KidsLabDe/tagged/freecad/preview_back.png

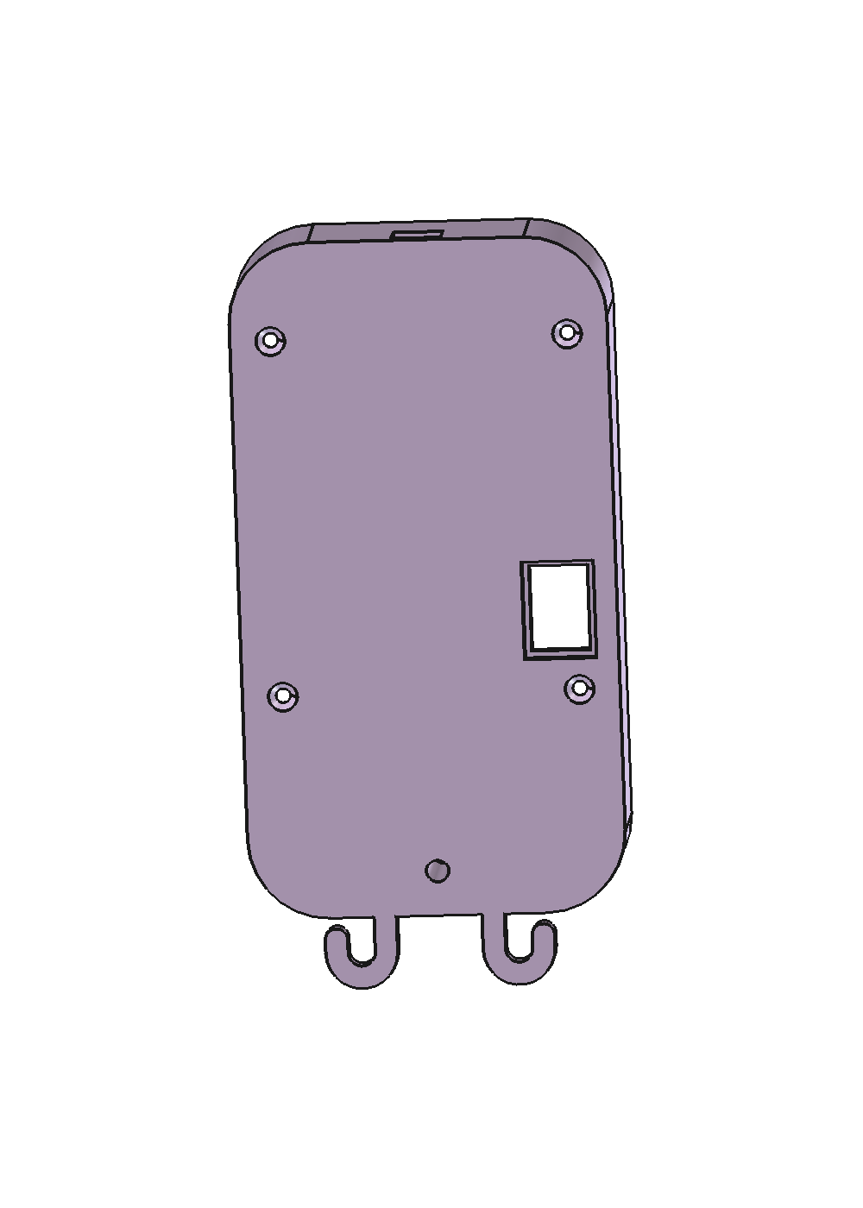
freecad/preview_back.png
