KidsLabDe/tagged/freecad/preview_front.png

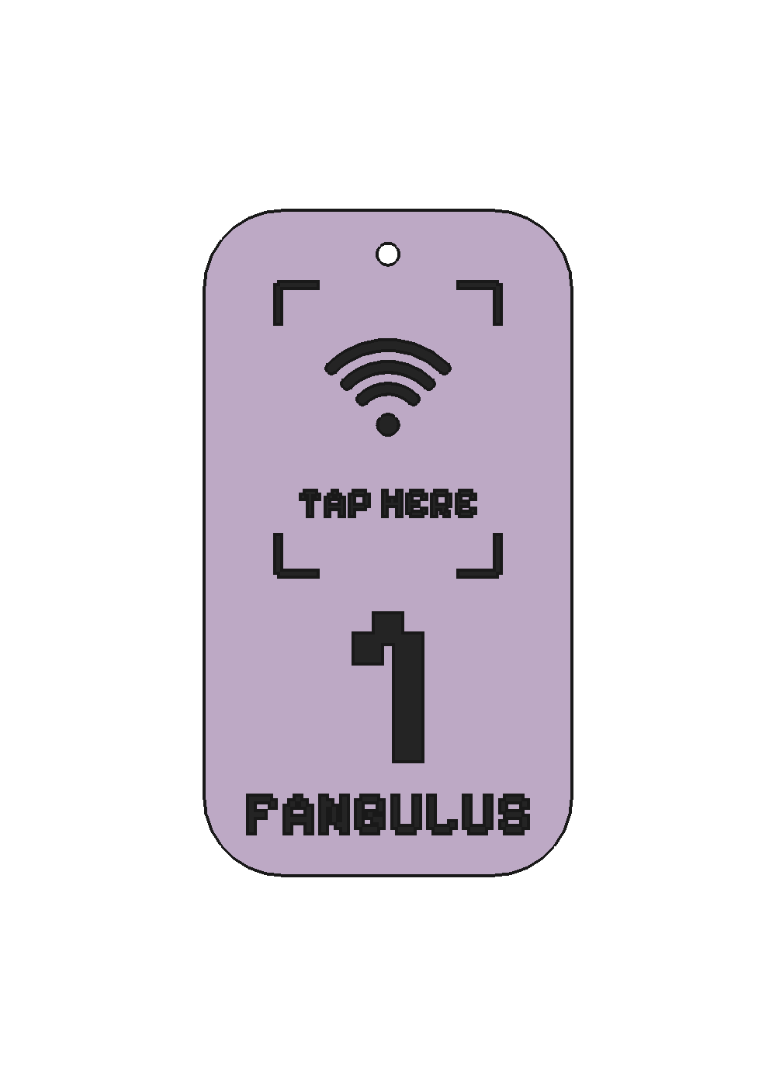
freecad/preview_front.png
