KidsLabDe/tagged/freecad/preview_fronten.png

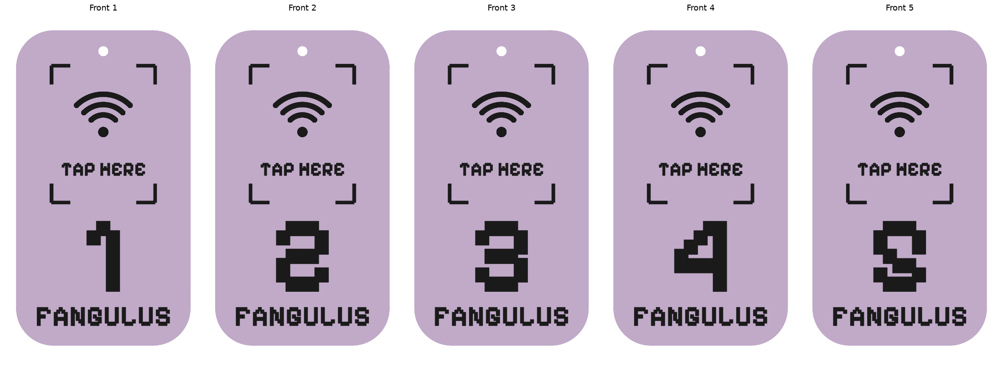
freecad/preview_fronten.png
