KidsLabDe/tagged/freecad/preview_inside.png

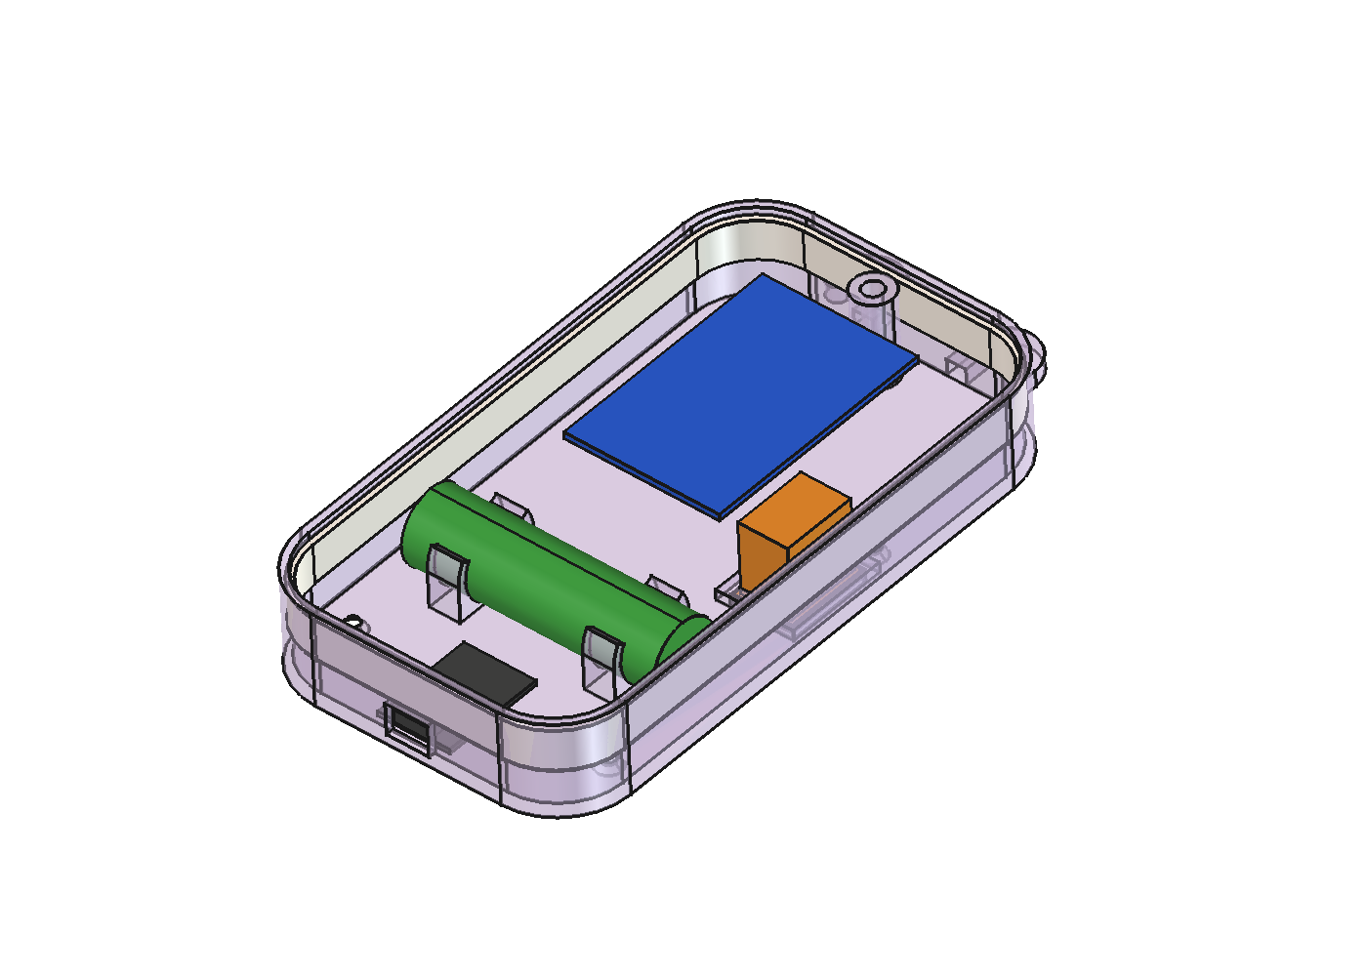
freecad/preview_inside.png
