KidsLabDe/tagged/freecad/DiscCase_Prusa_Front_1_2.3mf

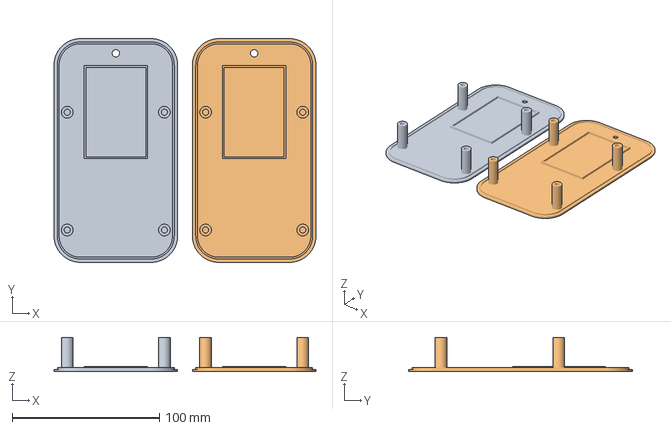
[picture p5: CAD file, 2026-10-29]
freecad/DiscCase_Prusa_Front_1_2.3mf
178.0 x 152.0 x 23.4 mm
Fangulus Front 1
Fangulus Front 2
