KidsLabDe/tagged/freecad/sample/flexbatter18650Px1.stl

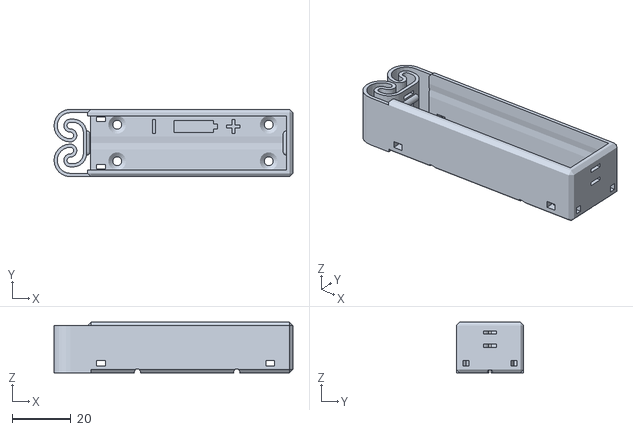
[picture p6: CAD file, 2026-10-28]
freecad/sample/flexbatter18650Px1.stl
81.2 x 22.9 x 17.2
