KidsLabDe/tagged/freecad/DiscCase_Prusa_Front_3_4.3mf

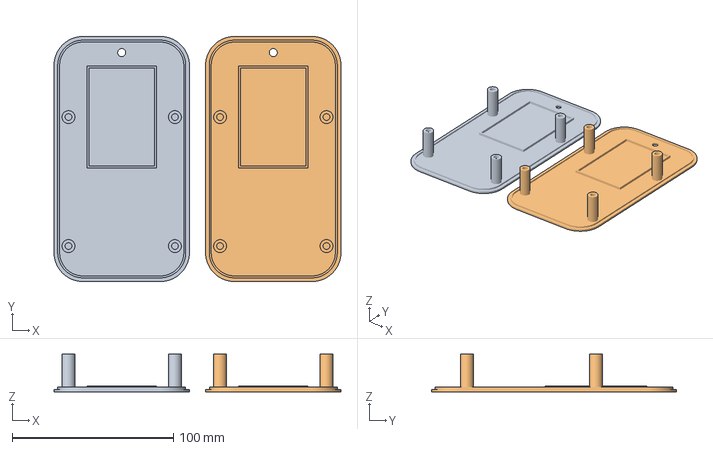
[picture p7: CAD file, 2026-10-29]
freecad/DiscCase_Prusa_Front_3_4.3mf
178.0 x 152.0 x 23.4 mm
Fangulus Front 3
Fangulus Front 4
