KidsLabDe/tagged/freecad/DiscCase_Prusa_Front_5.3mf

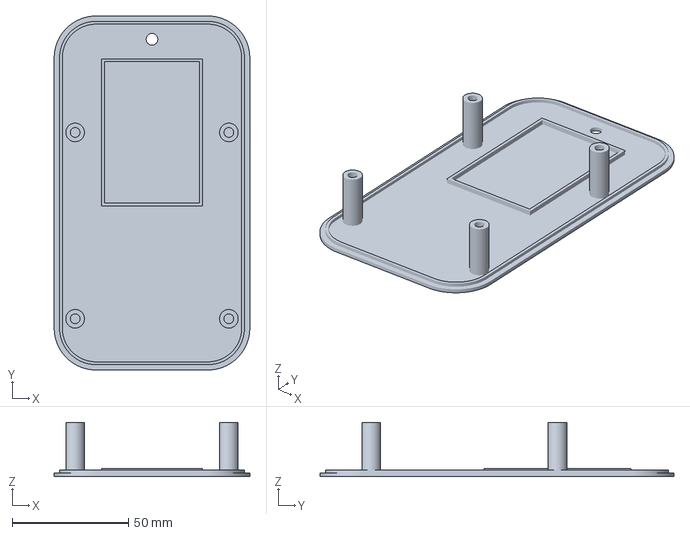
[picture p8: CAD file, 2026-10-29]
freecad/DiscCase_Prusa_Front_5.3mf
84.0 x 152.0 x 23.4 mm
