KidsLabDe/tagged/freecad/DiscCase_Front_1_Bambu.3mf

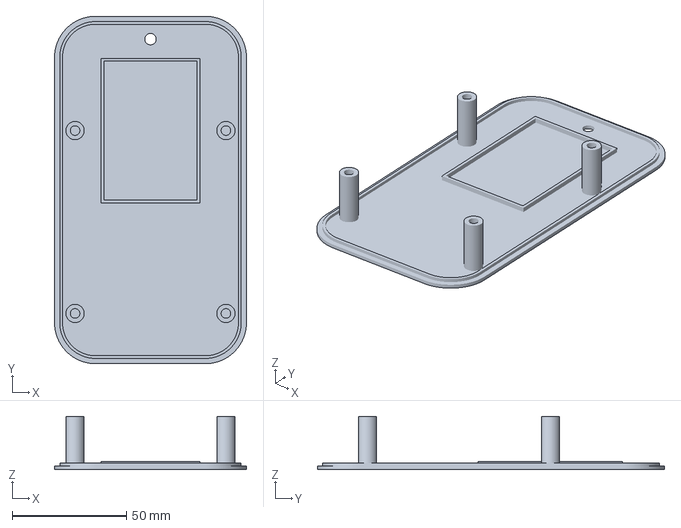
[picture p9: CAD file, 2026-10-28]
freecad/DiscCase_Front_1_Bambu.3mf
84.0 x 152.0 x 23.4 mm
