KidsLabDe/tagged/freecad/DiscCase.FCStd

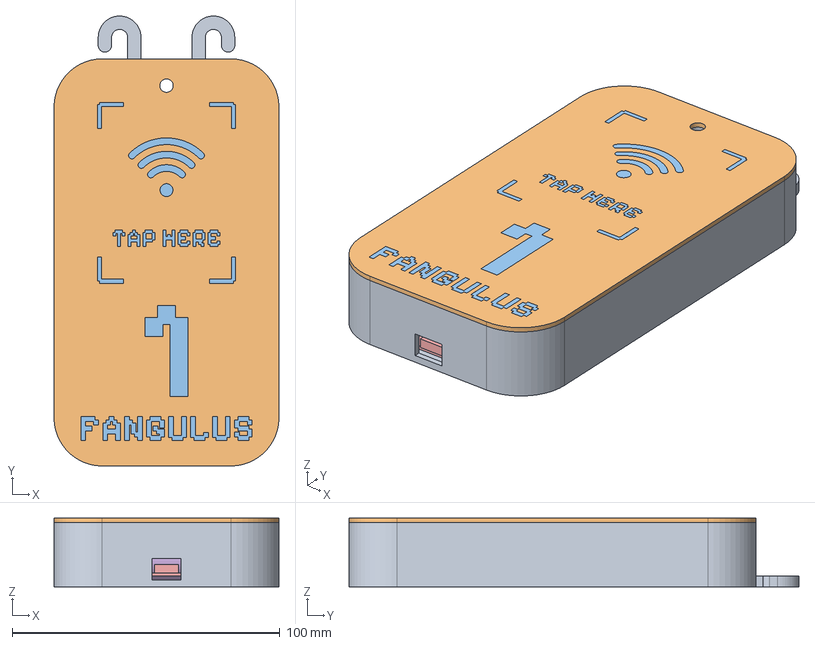
[picture p10: CAD file, 2026-10-28]
freecad/DiscCase.FCStd
84.0 x 168.0 x 25.6 mm
Unterteil
Deckel
Deckel_Logo
Bauteil_RC522
Bauteil_C6SuperMini
Bauteil_Akku18650
Bauteil_Schalter
Bauteil_LED_Streifen
