KidsLabDe/tagged/freecad/DiscCase_Druck_Bambu.3mf

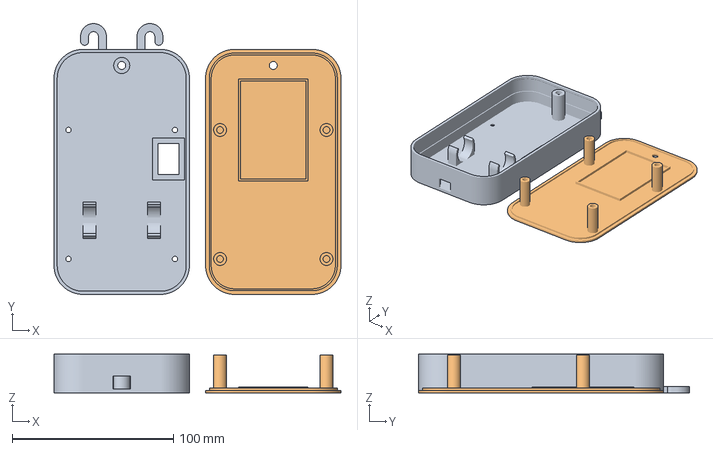
[picture p11: CAD file, 2026-10-28]
freecad/DiscCase_Druck_Bambu.3mf
178.0 x 168.0 x 24.0 mm
Unterteil
Deckel_mit_Logo
