KidsLabDe/tagged/freecad/DiscCase_Unterteil.stl

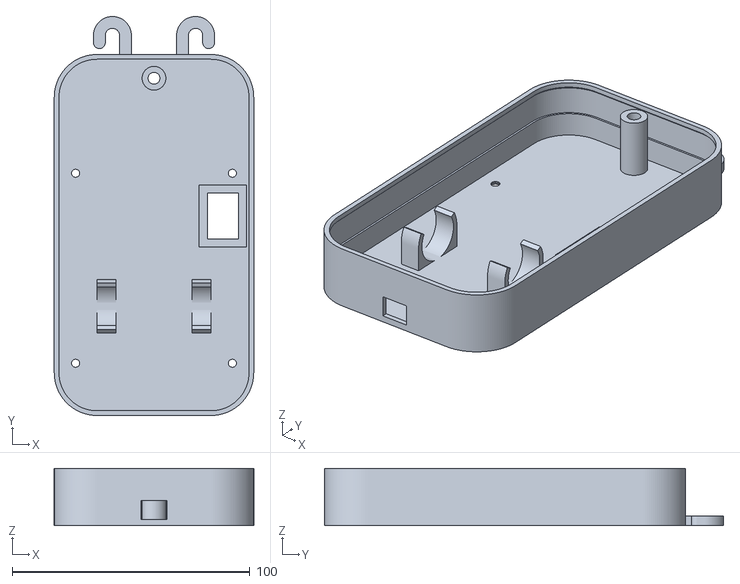
[picture p12: CAD file, 2026-10-28]
freecad/DiscCase_Unterteil.stl
84.0 x 168.0 x 24.0
