KidsLabDe/tagged/freecad/DiscCase_Deckel.stl

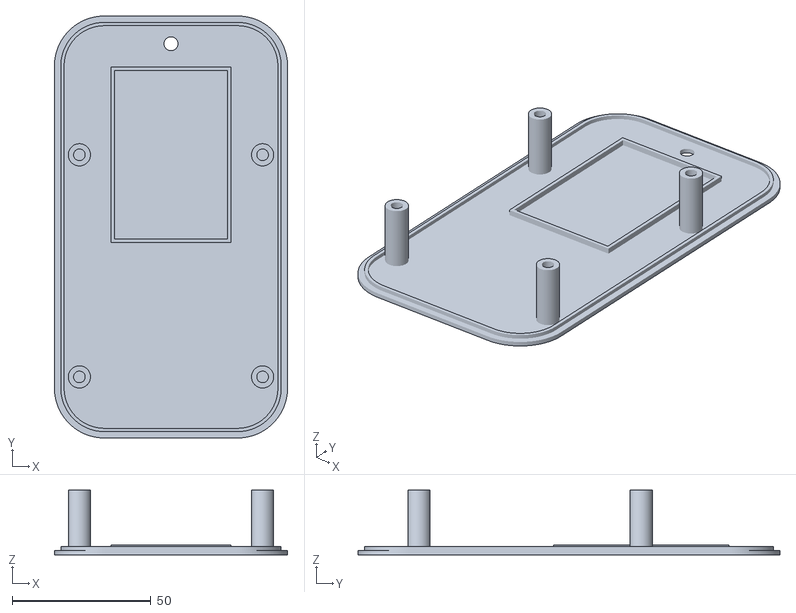
[picture p13: CAD file, 2026-10-28]
freecad/DiscCase_Deckel.stl
84.0 x 152.0 x 23.4
