KidsLabDe/tagged/freecad/DiscCase_Deckel_Logo.stl

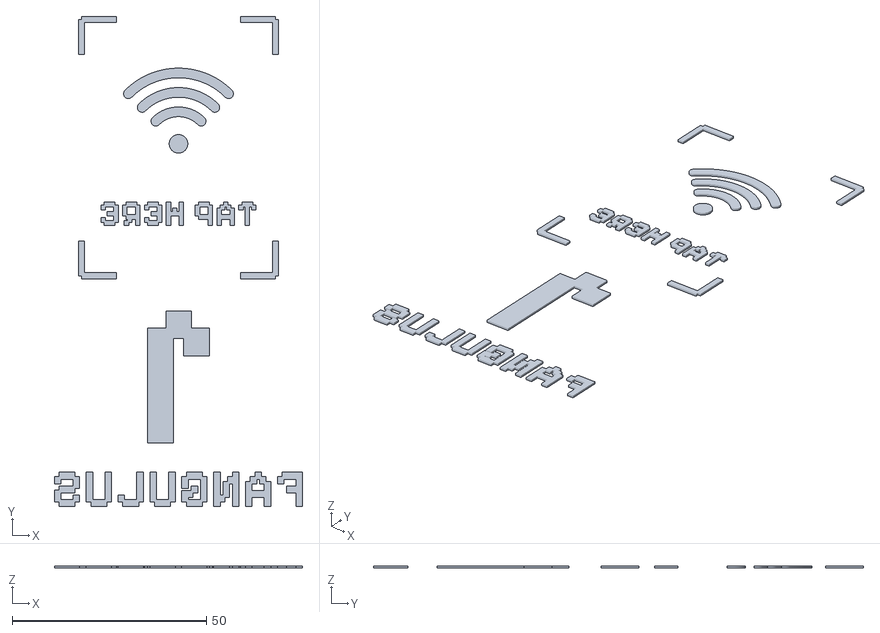
[picture p14: CAD file, 2026-10-28]
freecad/DiscCase_Deckel_Logo.stl
64.0 x 126.2 x 0.6
