KidsLabDe/tagged/(list of files, cad)

Other CAD files:
freecad/DiscCase_Front_4_Bambu.3mf
freecad/DiscCase_Front_3.3mf
freecad/DiscCase_Front_5_Bambu.3mf
freecad/DiscCase_Front_5.3mf
freecad/DiscCase_Front_4.3mf
freecad/DiscCase_Front_2.3mf
freecad/DiscCase_Front_3_Bambu.3mf
freecad/DiscCase_Druck.3mf
freecad/DiscCase_Front_2_Bambu.3mf
freecad/DiscCase_Front_1.3mf
freecad/sample/flexbatter.scad
