KidsLabDe/tagged/(commit log)

2026-10-28 Tagged!: RFID-Station mit CircuitPython-Firmware und FreeCAD-Gehaeuse
    [DiscCase.FCStd, DiscCase_Deckel.stl, DiscCase_Deckel_Logo.stl, DiscCase_Druck.3mf, DiscCase_Druck_Bambu.3mf, DiscCase_Unterteil.stl]
2026-10-28 S2-Mini-Firmware: LED-Ring-Animation, Karte -> 5x rot atmen
    Alter Kartentest bleibt als kartentest.py.
2026-10-28 Fronten 1-5: FANGULUS in Pixelify Bold, je Station ein Deckel
    - Texte in Pixelify Sans Bold (statische Instanz im Repo)
    - TAP HERE in der Lesezone, darunter grosse Stationsnummer und FANGULUS
    - DiscCase_Front_N(_Bambu).3mf je Station, nur Deckel + Logo-Inlay
    - group_3mf.py kommt ohne Unterteil aus
    [DiscCase.FCStd, DiscCase_Deckel.stl, DiscCase_Deckel_Logo.stl, DiscCase_Druck.3mf, DiscCase_Druck_Bambu.3mf, DiscCase_Front_1.3mf, DiscCase_Front_1_Bambu.3mf, DiscCase_Front_2.3mf]
2026-10-28 Unterteil: C6 Super Mini, Flexbatter-Akkuhalter, KCD1 in der Rueckwand, Haken
    - ESP32-C6 Super Mini auf Stegen mit Kabelkanal fuer die Akku-Pads unten,
    ersetzt S2 Mini + TP4056
    - 18650-Halter mit gedruckter Feder, portiert aus Flexbatter (Heinz Spiess,
    CC BY-SA), gekuerzt und niedriger, damit er zwischen die LEDs passt
    - KCD1-Wippschalter versenkt in einer Mulde in der Rueckwand
    - zwei flache Haken oben zum Aufhaengen
    - Deckel unveraendert
    [DiscCase.FCStd, DiscCase_Deckel.stl, DiscCase_Deckel_Logo.stl, DiscCase_Druck.3mf, DiscCase_Druck_Bambu.3mf, DiscCase_Front_1.3mf, DiscCase_Front_1_Bambu.3mf, DiscCase_Front_2.3mf]
2026-10-28 Firmware: S2 Mini und C6 Super Mini, Spielstation mit Server
    - Board, Box-Nummer, Server und Token aus settings.toml (Vorlage
    settings.toml.example), code.py ist auf allen Boxen gleich
    - Regenbogen beim Start, Ring zeigt den Zustand vom Server
    - Kartenscans gehen an den Server, Antwort als Animation
    - net.py: eigener minimaler HTTP-Client ohne Bundle-Bibliotheken
2026-10-28 Spielserver fuer fangulus.kidslab.de mit Webansicht
    - Teams beim ersten Scan, Stationen erobern mit Sperrzeit, Punkte ab
    allen eroberten Stationen, doppelt bei Dominanz, Laufzeit mit Countdown
    - Webansicht mit Stationen, Punkten, Restzeit, Sprachausgabe und
    Spielleitung (Passwort)
    - Docker-Image, Traefik-Compose und Deploy-Workflow wie bei kidslab.de
    - README: Spielregeln, Server, settings.toml
2026-10-28 Firmware: RC522 mit 38 dB, C6-LEDs auf GPIO20
    - Empfangsverstaerkung 38 statt 48 dB: bei aufliegender Karte uebersteuerte
    der Empfaenger, die meisten Lesevorgaenge brachen mit Fehlern ab
    - C6 Super Mini: LED-Streifen auf GPIO20, neben GND und 3V3
    - nach Spielende blinkt die Station bei einem Scan einmal in der Teamfarbe
2026-10-28 Server: Autostart mit der ersten Karte, Rueckmeldung nach Spielende
    - erste Karte in der Lobby startet das Spiel und erobert die Station,
    in der Spielleitung abschaltbar
    - Scans nach Spielende liefern die Teamfarbe statt nichts
    - README: Autostart, C6-Pin GPIO20
2026-10-28 Unterteil minimal, Helligkeit einstellbar, Anleitung in der Webansicht
    - Unterteil: C6-Halter entfernt (wird eingeklebt), hohe USB-Oeffnung;
    statt Flexbatter zwei Klammern fuer die 18650 mit angeloeteten Kabeln
    - Firmware: TAGGED_BRIGHTNESS in settings.toml, eingebaute LEDs des C6 aus
    - Server: Start ignoriert ein laufendes Spiel (kein Neustart per Doppelklick)
    - Webansicht: 1-2-3-Anleitung, solange kein Spiel laeuft
    [DiscCase.FCStd, DiscCase_Druck.3mf, DiscCase_Druck_Bambu.3mf, DiscCase_Front_1.3mf, DiscCase_Front_1_Bambu.3mf, DiscCase_Front_2.3mf, DiscCase_Front_2_Bambu.3mf, DiscCase_Front_3.3mf]
2026-10-29 Neues Spiel per Chip nach Spielende, Webansicht ohne Spiel nur Anleitung
    - Server: nach Spielende zeigt ein Scan 30 s lang das Ergebnis, danach
    startet der erste Chip eine neue Runde; Ergebnis der letzten Runde in /api/state
    - Webansicht: ohne laufendes Spiel Anleitung und letztes Ergebnis statt Stationen;
    laedt sich nach einem Update von index.html selbst neu
    - Firmware: bei Unentschieden atmet die Station in ihrer letzten Farbe
2026-10-29 Webansicht im Hum-Stil mit den Stationsfronten aus den 3MF-Dateien
    Papier, Karton und Packpapier statt dunkler Kacheln, Pixelify fuer Titel,
    Uhr und Punkte. Unten stehen die fuenf Fronten (Deckel und Einlage aus
    DiscCase_Front_1..5.3mf) im Gras: vor dem Spiel blinken sie rot und blau,
    im Spiel leuchten sie in der Farbe des Teams, das die Station haelt.
2026-10-29 Stationen: WLAN-Anzeige am Ring, mehrere WLANs, LED-Pin einstellbar
    - Beim Start gedimmt gelb, solange ein WLAN gesucht wird, dann einmal gruen;
    ohne WLAN blinkt der ganze Ring gelb
    - Weitere WLANs ueber TAGGED_WIFI_SSID_2/_PASSWORD_2 usw., die Station nimmt
    das erste bekannte Netz in Reichweite
    - Ohne eingetragenes WLAN kein Absturz mehr, nur eine Meldung
    - TAGGED_LED_PIN fuer Stationen mit dem LED-Streifen an einem anderen Pin
    - wlan.toml (lokale WLAN-Zugaenge) in .gitignore
2026-10-29 Prusa-MK4-Projekte fuer die Fronten, upload.py prueft Dateigroesse
    - prusa_3mf.py baut PrusaSlicer-2.9-Projekte (zwei Fronten je Platte),
    Logo auf Extruder 1, Farbwechsel per M600 in Schicht 1-3, ohne T-Befehle
    - prusa_mk4.ini: MK4-IS-Profil als Grundlage, disc_case.py ruft den Export mit auf
    - upload.py wartet auf die REPL und prueft die Groesse jeder Datei auf dem Board
    [DiscCase_Prusa_Front_1_2.3mf, DiscCase_Prusa_Front_3_4.3mf, DiscCase_Prusa_Front_5.3mf]
2026-10-30 Webansicht passt auf Laptops auf einen Bildschirm
    Ab 960 px Breite nimmt die Seite genau die Fensterhoehe ein: Uhr, Banner und
    Abstaende sind kompakter, "Was passiert ist" zeigt die letzten 4 Ereignisse,
    und die Stationsfronten fuellen die Resthoehe. Mit offener Spielleitung darf
    die Seite wieder scrollen.
